amsheth/Work/README.md

# Work
The repository of the work that I have done. This is an opensource Repo and you may use this repo for your personal projects.
