amsheth/Work/Code/Readme.md

# Preview
This area is for all the code that I have made and tested. I hope this code can help you develop some insight on what the product does.

# Code For Adafruit Feather M0
## Setup
We are going to setup the code and the libraries in the IDE. Please make sure that you have downloaded the libraries that have been specified in Preamble 1.2. Now we will initialize the libraries. Now each and every sensor has a specified struct and constructor which is expected to be called before using. Since our goal is not just to save the data but to also use it for future we want to make sure that we know which all sensors is it using and at which multiplexer select is it at, we are going to use predefined char array of an optimal length. \newline
Now in the void Setup() loop we will create the testing conditions where, we can test to see if the sensors are responding and what are its I2C values. This part is not really important but can be used for debugging mainly. In the setup we will begin the Wire and Serial library first and foremost, then we see if the SD card is inserted or not and if we can open the filename in the SD card. Now we iterate through the TCAselect from the Multiplexer to see if there is a sensor and if the sensor is found then we look for its I2C to confirm the type of the sensor and save it in an array to be used in the loop().
### Psuedocode:
```
void setup()
{
Wire.begin();
Serial.begin(115200);
Serial1.begin(9600);
  //while (!Serial) {
    //; // wait for serial port to connect. Needed for native USB port only
  //} // decomment if using serial
//pinMode(13, OUTPUT);
if (!SD.begin(cardselect)) {
   Serial.println("No SD Card");
   while(1);
  }
  Serial.println("SD OK");
if (!rtc.begin()) {
    Serial.println("No RTC");
  }
rtc.adjust(DateTime(F(__DATE__), F(__TIME__)));
  rtc.start();
char filename[15];
strcpy(filename, "/ABC.TXT");
/*for (uint8_t i = 0; i < 100; i++) {
    filename[7] = '0' + i/10;
    filename[8] = '0' + i%10;
    // create if does not exist, do not open existing, write, sync after write
    if (! SD.exists(filename)) {
      break;
    }
  }*/
logfile = SD.open(filename, FILE_WRITE);

if (!logfile) {
  Serial.print("Couldn't create ");
  Serial.println(filename);
}
Serial.print("Writing to ");
Serial.println(filename);
    for (int j=0;j<7;j++){
      adr[j]=0;
    }
    delay(1000);
    Serial.println("\nTCAScanner ready!");
    
    for (uint8_t t=0; t<8; t++) {
      tcaselect(t);
      Serial.print("TCA Port #"); Serial.println(t);

      for (uint8_t addr = 0; addr<=127; addr++) {
        if (addr == TCAADDR || addr == 104 ) continue;

        Wire.beginTransmission(addr);
        if (!Wire.endTransmission()) {
          Serial.print("Found I2C 0x");  Serial.println(addr,HEX);
          if (addr!=104){
          adr[t]=addr;}   
          bool status;
          delay(100);
          Serial.begin(9600);      
          if (mlx.begin()) {
          Serial.println("Found MLX990614 sensor");
          Serial.print("Emissivity = "); Serial.println(mlx.readEmissivity());
        };
         if (sensor.begin()==true) {
          Serial.println("Found AS7265X sensor");
          //sensor.disableIndicator();
        }
        if (tcs.begin()) {
          Serial.println("Found RGB sensor");
         } 
         if (bmp.begin(0x77)){
          Serial.println("Found BME sensor");
         }
      }
    }}
    for (int j=0;j<8;j++){
      Serial.print(adr[j]);
      Serial.print(",");
    }
    Serial.print("/n");
    Serial.println("_____________________________ Code Begins _____________________________");}
```
## Triad Sensor
We are going to use the Sparkfun AS7265X library for the Triad sensor. The data is collected in 18 different string values (even if they are actually floating numbers.). We will have to define the sensor name. Now we for everytime we take a measurement we will have to go like "\textit{sensor}.takeMeasurements()". This takes the measurements from the sensors and stores it in a heap, now to pop the values of the heap we will call the getcalibrated\textbf{X}() function where \textbf{X} denotes the letters and its wavelength corresponding to it.

|Letter | Wavelength | Color (Hex) |
| :---: | :---: | :---: |
|A | 410nm | `#7E00DB` |
|B | 435nm | `#2300FF` |
|C | 460nm | `#007bFF` | 
|D | 485nm | `#00EAFF` |
|E | 510nm | `#00FF00` |
|F | 535nm | `#70FF00` |
|G | 560nm | `#c3FF00` |
|H | 585nm | `#FFEF00` |
|R | 610nm | `#FF9b00` |
|I | 645nm | `#FF0000` |
|S | 680nm | `#CC0000` |
|J | 705nm | `#C90000` |
|T | 730nm | `#990000` |
|U | 760nm | `#940000` |
|V | 810nm | Infrared |
|W | 860nm | Infrared |
|K | 900nm | Infrared |
|L | 940nm | Infrared |

Once we have saved this value in a string we have to go through a few more steps like converting the string into a char and then into an array of char and saving it in the data variables.
### Psuedocode:

```
void triad(int sel){
  tcaselect(sel);
  sensor.takeMeasurements();
  
  String  a = String(sensor.getCalibratedA(), 2);
  String b = String(sensor.getCalibratedB(), 2);
  String c = String(sensor.getCalibratedC(), 2);
  String d = String(sensor.getCalibratedD(), 2);
  String e = String(sensor.getCalibratedE(), 2);
  String f = String(sensor.getCalibratedF(), 2);

  String g = String(sensor.getCalibratedG(), 2);
  String h = String(sensor.getCalibratedH(), 2);
  String i = String(sensor.getCalibratedR(), 2);
  String j = String(sensor.getCalibratedI(), 2);
  String k = String(sensor.getCalibratedS(), 2);
  String l = String(sensor.getCalibratedJ(), 2);

  String m = String(sensor.getCalibratedT(), 2);
  String n = String(sensor.getCalibratedU(), 2);
  String o = String(sensor.getCalibratedV(), 2);
  String p = String(sensor.getCalibratedW(), 2);
  String q = String(sensor.getCalibratedK(), 2);
  String r = String(sensor.getCalibratedL(), 2);
  
  char A[9]; char B[9]; char C[9]; char D[9]; char E[9]; char F[9];
  char G[9]; char H[9]; char I[9]; char J[9]; char K[9]; char L[9];
  char M[9]; char N[9]; char O[9]; char P[9]; char Q[9]; char R[9];
  
  a.toCharArray(A, 9); b.toCharArray(B, 9); c.toCharArray(C, 9); d.toCharArray(D, 9); e.toCharArray(E, 9); f.toCharArray(F, 9);
  g.toCharArray(G, 9); h.toCharArray(H, 9); i.toCharArray(I, 9); j.toCharArray(J, 9); k.toCharArray(K, 9); l.toCharArray(L, 9);
  m.toCharArray(M, 9); n.toCharArray(N, 9); o.toCharArray(O, 9); p.toCharArray(P, 9); q.toCharArray(Q, 9); r.toCharArray(R, 9);

  sprintf(dat0, "Triad, UP, SEN%u,%9s,%9s,%9s,%9s,%9s,%9s,%9s,%9s,%9s,%9s,%9s,%9s,%9s,%9s,%9s,%9s,%9s,%9s\n",/* now.year(), now.month(), now.day(), now.hour(), now.minute(), now.second(), now.unixtime(),*/sel, A, B, C, D, E, F, G, H, I, J, K, L, M, N, O, P, Q, R);
  
  Serial.print(dat0);
  Serial1.write(dat0);
  delay(1000);
  logfile.print(dat0);
}
```

## RGB Sensor
For the RGB sensor we are using the TCS34725 Library. When creating the constructor we are going to allot a gain and integration time too. The values from the sensor are saved as a "uint16\_t", however the Cpp doesn't support it like C used to do, so we have to convert these into int or float values.
### Psuedocode:
```
void rgb(int sel){
  tcaselect(sel);
  uint16_t r, g, b, c;
  tcs.getRawData(&r, &g, &b, &c);
  red=r;
  blue=b;
  green=g;
  col=c;
  sprintf(dat4,"RGB, SEN%u, R:%u\tG:%u\tB:%u\tC:%u\n",sel,red,green,blue,col);                  
  Serial.print(dat4);
  Serial1.write(dat4);
  delay(1000);
  logfile.print(dat4);
}
```
## Thermal sensor
The thermal sensor uses the MLX90614 library. The data is saved as a double value. The sensor can take both the object temperature and the ambient temperature. 
### Psuedocode
```
void thermal(int sel){
  tcaselect(sel);
  double A3=(mlx.readAmbientTempC());
  double B3= mlx.readObjectTempC();
  sprintf(dat3,"Thermal,SEN%u, Ambient = %8f*C\tObject = %8f*C\n",sel,A3,B3);
  Serial.print(dat3);
  Serial1.write(dat3);
  delay(1000);
  logfile.print(dat3);
}
```

## Environment Sensor
The environment sensor is the sensor which is used to measure pressure, altitude, humidty and temperature. 
### Psuedocode

```
void env(int sel){
   tcaselect(sel);
    float BMPt = (bmp.readTemperature());                               // read the temperature
    float BMPp = (bmp.readPressure() / 100.0F);                         // read the pressure
    float BMPa = (bmp.readAltitude(SEALEVELPRESSURE_HPA));  
    float BMPh = (bmp.readHumidity());
    sprintf(dat2,"BME280, SEN%u, BMP280 temp:%f, Pressure:%f, Elevation:%f, Humidity:%f \n",sel,BMPt,BMPp,BMPa,BMPh);
    Serial.print(dat2);
    Serial1.write(dat2);
    delay(1000);
    logfile.print(dat2);
}
```

## The Loop
This Loop is used to run the code. The Loop code is used to instantiate the modules that we just made.
### Psuedocode

```
void loop() 
{
  DateTime x = rtc.now();
  sprintf(dat5,"%04d/%02d/%02d,%02d:%02d:%02d \n",x.year(),x.month(),x.day(),x.hour(),x.minute(),x.second());
  Serial.print(dat5);
  Serial1.write(dat5);
  delay(1000);
  logfile.print(dat5);
  ///////////////////////////////////////////////////
  for (int i=0;i<8;i++){
    if (adr[i]==0){
      continue;
    }
    else if (adr[i]==90){
     thermal(i); 
    }
    else if (adr[i]==41){
      rgb(i);
    }
    else if (adr[i]==73){
      triad(i);
    }
    else if (adr[i]==119){
      env(i);
    }
    
  }  
  logfile.flush();
  delay(60000);
}
```

# Code For Boron Particle
## Setup
The Boron is only required to read the values and upload it over the LTE network test. This makes Boron a secondary equipment which is not very important for the functioning of the Main system. The setup for Boron is very simple as its a seperate entity. We just initialize the UART connection as this is what we will be using to read the values from the Feather M0.
```
#include "Particle.h"

SYSTEM_THREAD(ENABLED);
String message = "";

const char *eventName = "pump_system";

void setup() {
    Serial1.begin(115200);
    //Serial.begin(115200);
   
    Time.zone(-6);
}
char a[150];
```
## Loop
The Loop contains an if statement which asks the UART if it has space to read the values, then read the values incoming and save it in the string message. This string is then Published over the LTE network. We can set the Publish to PRIVATE as we dont want the other Particle devices to use this function as a trigger to read the values abruptly.

```
void loop() {
    if(Serial1.available()>0){
        message=Serial1.readStringUntil('\n');
        Particle.publish(eventName, message, PRIVATE);
    }
 }
```

# How do the 2 codes link?
I am using the UART connection to send and recieve data via the Boron. The Serial interface used is the Serial1. This is used as it is completely unattached to Serial and is usually not affected by it. Usually any Baud Rate is good enough but it is very useful for us to use the 9600 as it allows us to debug the issues. However I have switched to 115200 as soon as I felt that I had enough confidence in my equipment.

# Issues Faced
Sometimes the Serial1 would not upload the right values to the Boron. It was due to main 3 reasons:
- The Serial was displaying some outputs and it was taking up some amount of power.
- The connection between RX-TX on the feather and TX-RX on the Boron were not impedance proof.
- The Connection for RX-TX was not connected properly.This is RX of one board connected to TX of the other.
