amsheth/Work/(commit log)

2023-01-08 Create ABT PCB.md
2023-01-08 Update ABT PCB.md
2023-05-16 Rename ABT PCB.md to Readme.md
